icelord75/Preluder/README.md

# Prelude ExtraGuages and Odometer

Secondary VFD dashboard display and Dot matrix LED display replacement for mechanical odometer in Honda Prelude IV

## Supported modes:

 - Arduino Mega2561 controller
 - OLED mode and values display with dimming feature
 - Voltmeter
 - Oil pressure (VDO) / Oil temperature (NTC)
 - AirFuelRatio sensor / EGT sensor
 - Contactless brakes temperature (PIR)
 - Alarm system
 - Precise configure wheel/VSS ratio
 - Total mileage
 - A/B trip (up to 9999.9km)
 - Motor hours counter
 - Configurable LED needle illumination with dimming feature
 - Configurable Electroluminescence instrumental cluster illumination controller
 - Outside Temperature (DS1820 sensor)

## License

**Prelude ExtraGuages and Odometer** is available under GPL License.

PreludeExtraGuages (https://www.youtube.com/watch?v=6HGEkpkcAlo)

PreludeOdomeer (https://www.youtube.com/watch?v=CyNxM1pS85o)
