icelord75/Preluder/hardware/bare.brd

## EAGLE design hardware/bare.brd (2019-04-04)

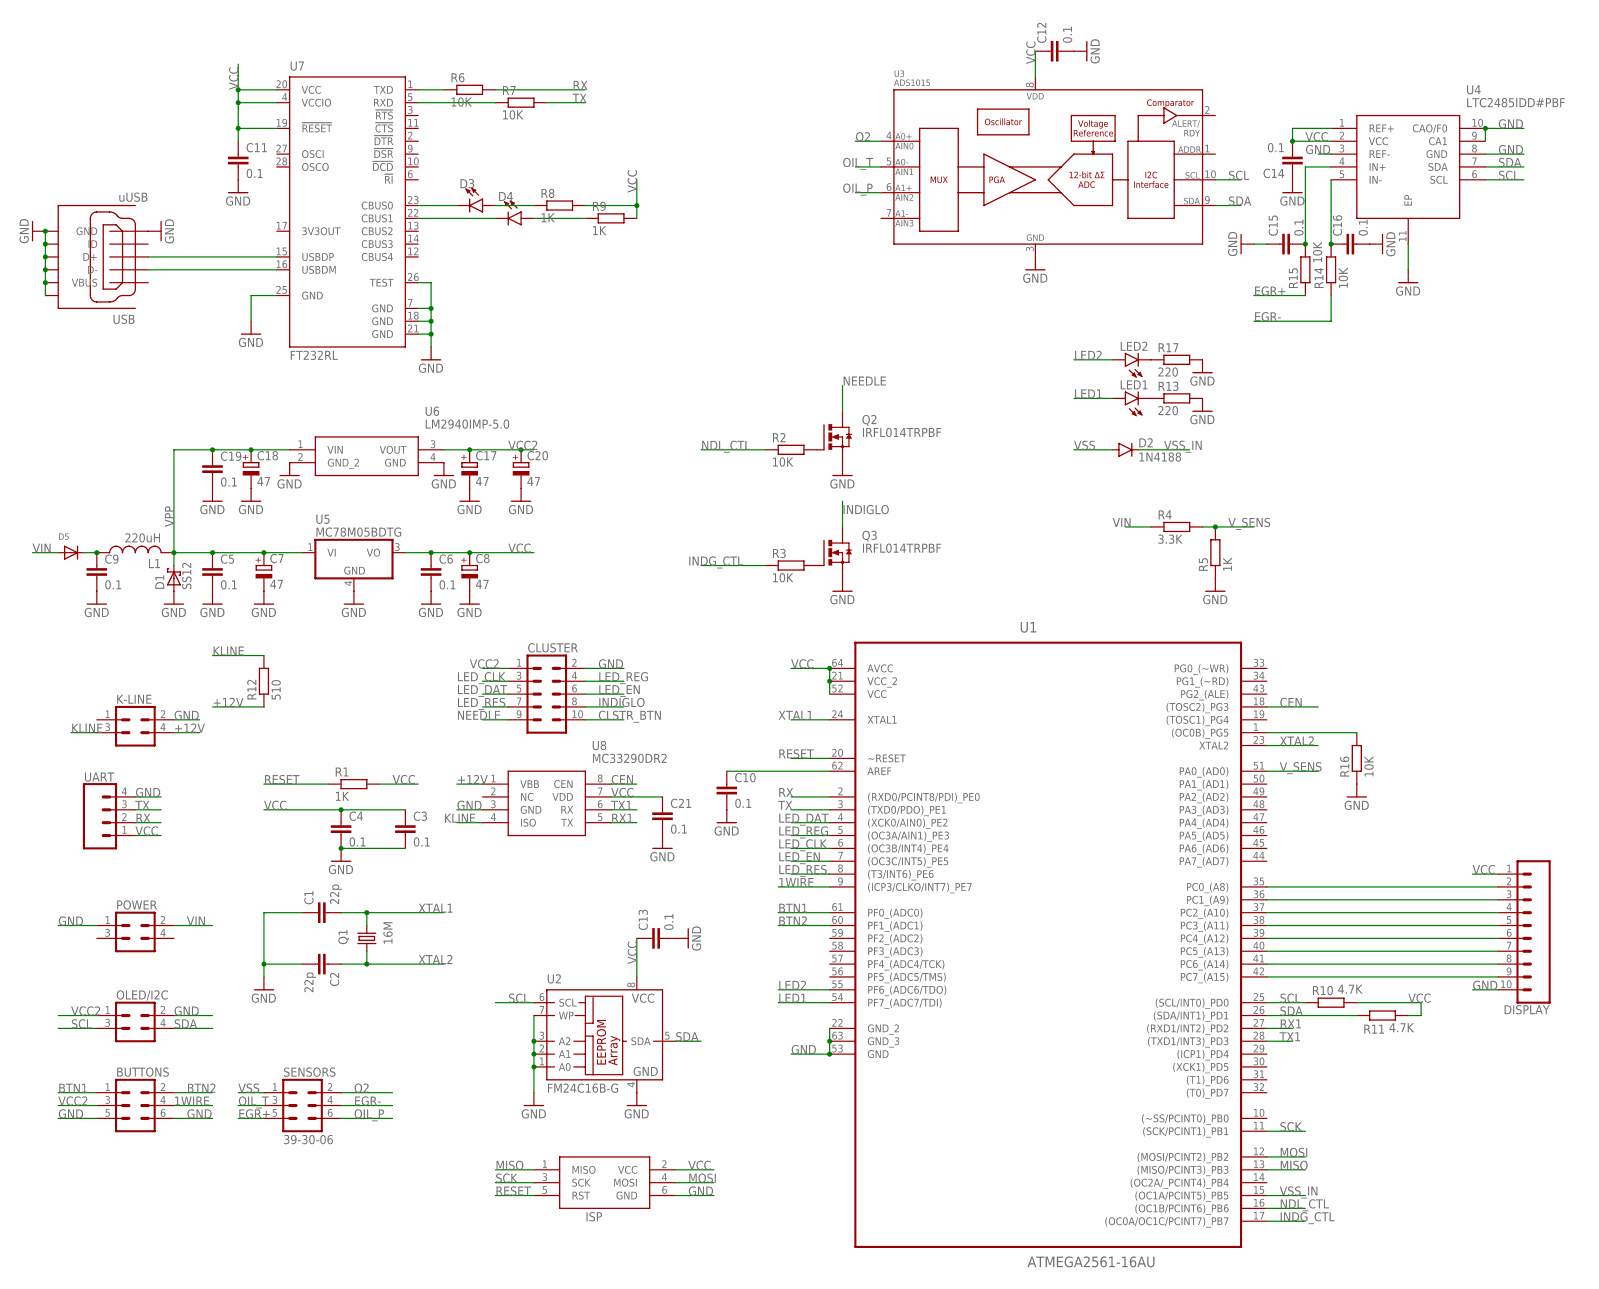
[picture p1: schematic bare.sch]

Parts:
BUTTONS: 39-30-06; 39-30-?06?
C1, C2: 22p; C0603K
C3, C4, C10, C11, C13, C14, C15, C16, C21: 0.1; C0603K
C5, C6, C9, C12, C19: 0.1; C0805K
C7, C8, C17, C18, C20: 47; SMC_C
CLUSTER: 39-30-10; 39-30-?10?
D1: SS12; SOD80C
D2: 1N4188; SOD-323
D3: GREEN; LED-0603
D4: RED; LED-0603
D5: DIODESMA; SMADIODE
DISPLAY: CONN_10"; 1X10
ISP: AVRISP-6; AVRISP
K-LINE: 39-30-04; 39-30-?04?
L1: 220uH; PIS2816
LED1, LED2: LEDCHIP-LED0805; CHIP-LED0805
OLED/I2C: 39-30-04; 39-30-?04?
POWER: 39-30-04; 39-30-?04?
Q1: 16M; 3.2X2.5_KX-7
Q2, Q3: IRFL014TRPBF; SOT223
R1, R5, R8, R9: 1K; R0603
R2, R3, R6, R7, R14, R15, R16: 10K; R0603
R4: 3.3K; R0603
R10, R11: 4.7K; R0603
R12: 510; R0603
R13, R17: 220; R0603
SENSORS: 39-30-06; 39-30-?06?
U1: ATMEGA2561-16AU; QFP80P1600X1600X120-64N
U2: FM24C16B-G; SO-08
U3: ADS1015; MSOP10
U4: LTC2485IDD#PBF; SON50P300X300X80-11N
U5: MC78M05BDTG; DPACK_3
U6: LM2940IMP-5.0; SOT230P696X180-4N
U7: FT232RL; SSOP28
U8: MC33290DR2; SOIC127P600X175-8N
UART: UART; 1X04
USB: uUSB; GHI-CONNECTORS_10118192-0001LF(MICRO-USB-B-AMPHENOL-FCI)

Connections:
1WIRE: BUTTONS.4, U1.9 ((ICP3/CLKO/INT7)_PE7)
+12V: K-LINE.4, R12.1, U8.1 (VBB)
BTN1: BUTTONS.1, U1.61 (PF0_(ADC0))
BTN2: BUTTONS.2, U1.60 (PF1_(ADC1))
CEN: U1.18 ((TOSC2)_PG3), U8.8 (CEN)
CLSTR_BTN: CLUSTER.10, R16.2, U1.1 ((OC0B)_PG5)
EGR+: R15.1, SENSORS.5
EGR-: R14.1, SENSORS.4
GND: BUTTONS.5, BUTTONS.6, C1.1, C2.2, C3.2, C4.2, C5.2, C6.2, C7.-, C8.-, C9.2, C10.2, C11.2, C12.2, C13.2, C14.1, C15.1, C16.2, C17.-, C18.-, C19.2, C20.-, C21.2, CLUSTER.2, D1.2 (A), DISPLAY.10, ISP.6 (GND), K-LINE.2, OLED/I2C.2, POWER.1, Q2.3 (S), Q3.3 (S), R5.1, R13.2, R16.1, R17.2, U1.22 (GND_2), U1.53 (GND), U1.63 (GND_3), U2.1 (A0), U2.2 (A1), U2.3 (A2), U2.4 (GND), U2.7 (WP), U3.3 (VSS), U4.3 (REF-), U4.8 (GND), U4.9 (CA1), U4.10 (CAO/F0), U4.11 (EP), U5.4 (GND), U6.2 (GND_2), U6.4 (GND), U7.7 (GND), U7.18 (GND), U7.21 (GND), U7.25 (GND), U7.26 (TEST), U8.3 (GND), UART.4, USB.CGND1 (SGND1), USB.CGND2 (SGND2), USB.CGND3 (SGND3), USB.CGND4 (SGND4), USB.CGND5 (SGND5), USB.CGND6 (SGND6), USB.GND
INDG_CTL: R3.1, U1.17 ((OC0A/OC1C/PCINT7)_PB7)
INDIGLO: CLUSTER.8, Q3.2 (D), Q3.4 (D)
KLINE: K-LINE.3, R12.2, U8.4 (ISO)
LED1: LED1.A, U1.54 (PF7_(ADC7/TDI))
LED2: LED2.A, U1.55 (PF6_(ADC6/TDO))
LED_CLK: CLUSTER.3, U1.6 ((OC3B/INT4)_PE4)
LED_DAT: CLUSTER.5, U1.4 ((XCK0/AIN0)_PE2)
LED_EN: CLUSTER.6, U1.7 ((OC3C/INT5)_PE5)
LED_REG: CLUSTER.4, U1.5 ((OC3A/AIN1)_PE3)
LED_RES: CLUSTER.7, U1.8 ((T3/INT6)_PE6)
MISO: ISP.1 (MISO), U1.13 ((MISO/PCINT3)_PB3)
MOSI: ISP.4 (MOSI), U1.12 ((MOSI/PCINT2)_PB2)
unnamed: Q2.1 (G), R2.2
unnamed: Q3.1 (G), R3.2
unnamed: C10.1, U1.62 (AREF)
unnamed: R6.1, U7.1 (TXD)
unnamed: R7.1, U7.5 (RXD)
unnamed: U7.15 (USBDP), USB.D+
unnamed: U7.16 (USBDM), USB.D-
unnamed: D3.C, U7.23 (CBUS0)
unnamed: D4.C, U7.22 (CBUS1)
unnamed: D3.A, R8.1
unnamed: D4.A, R9.1
unnamed: LED1.C, R13.1
unnamed: LED2.C, R17.1
unnamed: C9.1, D5.C, L1.1
unnamed: DISPLAY.9, U1.42 (PC7_(A15))
unnamed: C16.1, R14.2, U4.5 (IN-)
unnamed: C15.2, R15.2, U4.4 (IN+)
unnamed: DISPLAY.8, U1.41 (PC6_(A14))
unnamed: DISPLAY.7, U1.40 (PC5_(A13))
unnamed: DISPLAY.6, U1.39 (PC4_(A12))
unnamed: DISPLAY.5, U1.38 (PC3_(A11))
unnamed: DISPLAY.4, U1.37 (PC2_(A10))
unnamed: DISPLAY.3, U1.36 (PC1_(A9))
unnamed: DISPLAY.2, U1.35 (PC0_(A8))
NDL_CTL: R2.1, U1.16 ((OC1B/PCINT6)_PB6)
NEEDLE: CLUSTER.9, Q2.2 (D), Q2.4 (D)
O2: SENSORS.2, U3.4 (AIN0)
OIL_P: SENSORS.6, U3.6 (AIN2)
OIL_T: SENSORS.3, U3.5 (AIN1)
RESET: ISP.5 (RST), R1.1, U1.20 (~RESET)
RX: R6.2, U1.2 ((RXD0/PCINT8/PDI)_PE0), UART.2
RX1: U1.27 ((RXD1/INT2)_PD2), U8.5 (TX)
SCK: ISP.3 (SCK), U1.11 ((SCK/PCINT1)_PB1)
SCL: OLED/I2C.3, R10.1, U1.25 ((SCL/INT0)_PD0), U2.6 (SCL), U3.10 (SCL), U4.6 (SCL)
SDA: OLED/I2C.4, R11.1, U1.26 ((SDA/INT1)_PD1), U2.5 (SDA), U3.9 (SDA), U4.7 (SDA)
TX: R7.2, U1.3 ((TXD0/PDO)_PE1), UART.3
TX1: U1.28 ((TXD1/INT3)_PD3), U8.6 (RX)
VCC: C3.1, C4.1, C6.1, C8.+, C11.1, C12.1, C13.1, C14.2, C21.1, DISPLAY.1, ISP.2 (VCC), R1.2, R8.2, R9.2, R10.2, R11.2, U1.21 (VCC_2), U1.52 (VCC), U1.64 (AVCC), U2.8 (VCC), U3.8 (VDD), U4.1 (REF+), U4.2 (VCC), U5.3 (VO), U7.4 (VCCIO), U7.19 (!RESET), U7.20 (VCC), U8.7 (VDD), UART.1
VCC2: BUTTONS.3, C17.+, C20.+, CLUSTER.1, OLED/I2C.1, U6.3 (VOUT)
VIN: D5.A, POWER.2, R4.1
VPP: C5.1, C7.+, C18.+, C19.1, D1.1 (K), L1.2, U5.1 (VI), U6.1 (VIN)
VSS: D2.A, SENSORS.1
VSS_IN: D2.C, U1.15 ((OC1A/PCINT5)_PB5)
V_SENS: R4.2, R5.2, U1.51 (PA0_(AD0))
XTAL1: C1.2, Q1.3 (2), U1.24 (XTAL1)
XTAL2: C2.1, Q1.1, U1.23 (XTAL2)

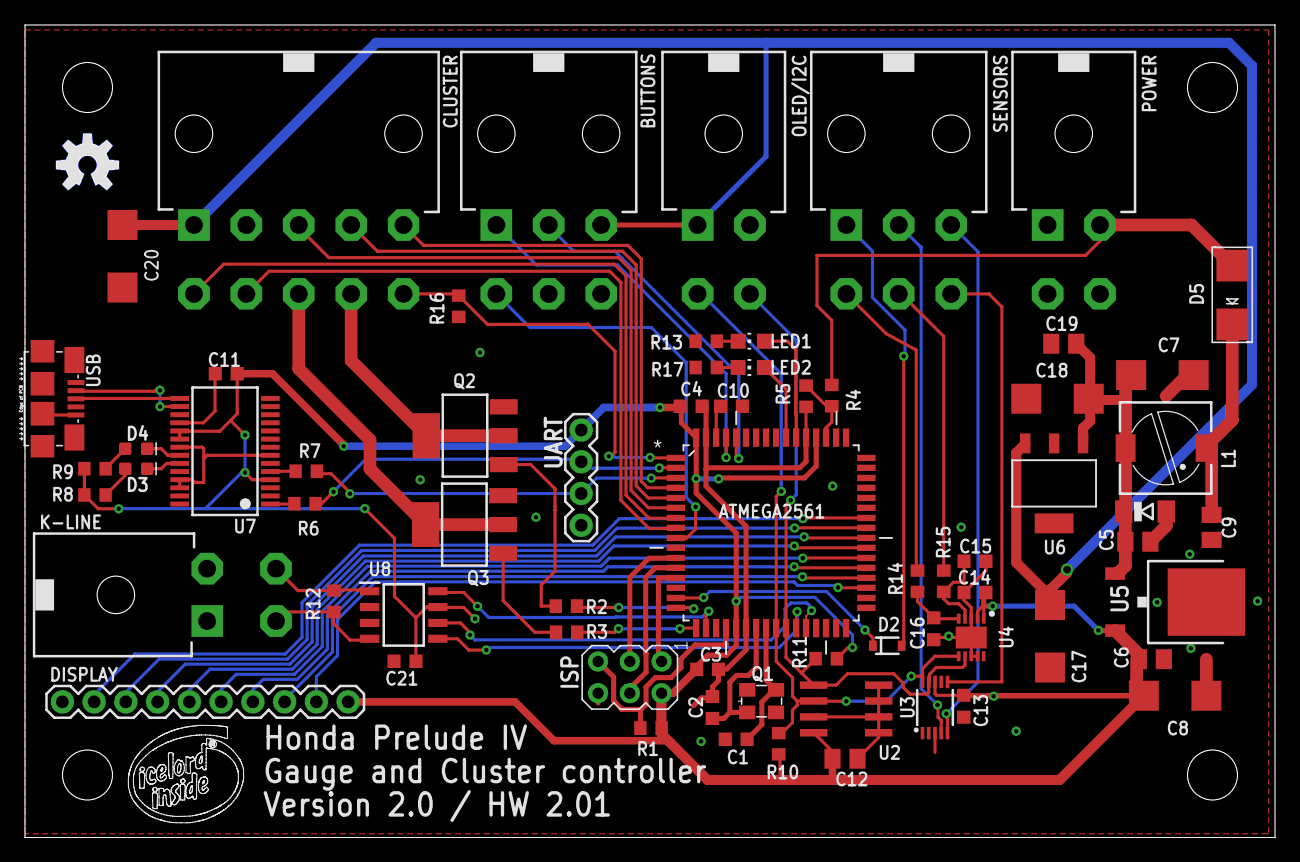
[picture p2: board bare.brd from above]

Board: 2 copper layers, 100.0 x 65.0 mm, 70 parts (1 on the bottom side), 67 nets.

Other parts of the board:
U$1: ICELORD_SMALL
U$2: OSHW-LOGO-M
U$3: OSHW-LOGO-M_COPPER
