icelord75/Preluder/(notices)

Notices in the files:
parts and their libraries:
crystal-geyer_V1_0: Copyright: Geyer-Electronic
SparkFun-Connectors: Licensing: Creative Commons ShareAlike 4.0 International - https://creativecommons.org/licenses/by-sa/4.0
con-molex-mini-fit: Copyright (C) 2011, Bob Starr
